viorels/zynthian-hw/MINI_V2/footprints/3dmodels/PJ-320A.step

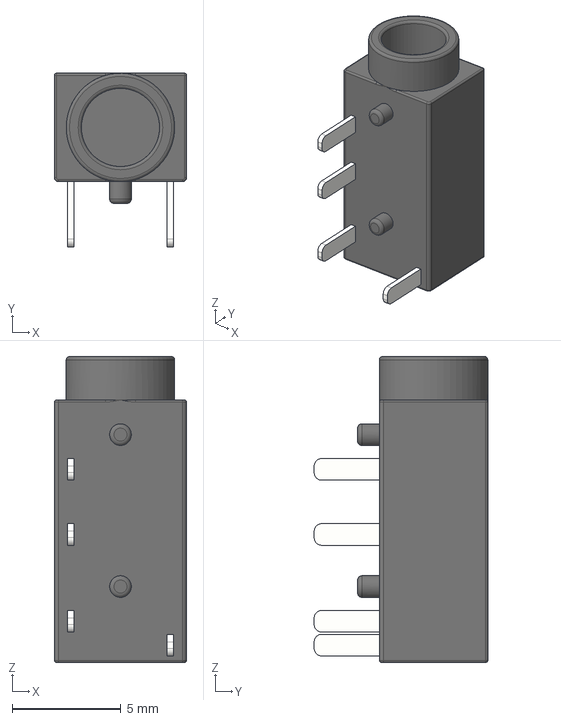
[picture p1: CAD file, 2025-03-14]
MINI_V2/footprints/3dmodels/PJ-320A.step
6.10 x 8.00 x 14.1 mm
