viorels/zynthian-hw/MINI_V2/zynthian-mini.kicad_pcb

## KiCad design MINI_V2/zynthian-mini.kicad_pcb (2025-03-16)

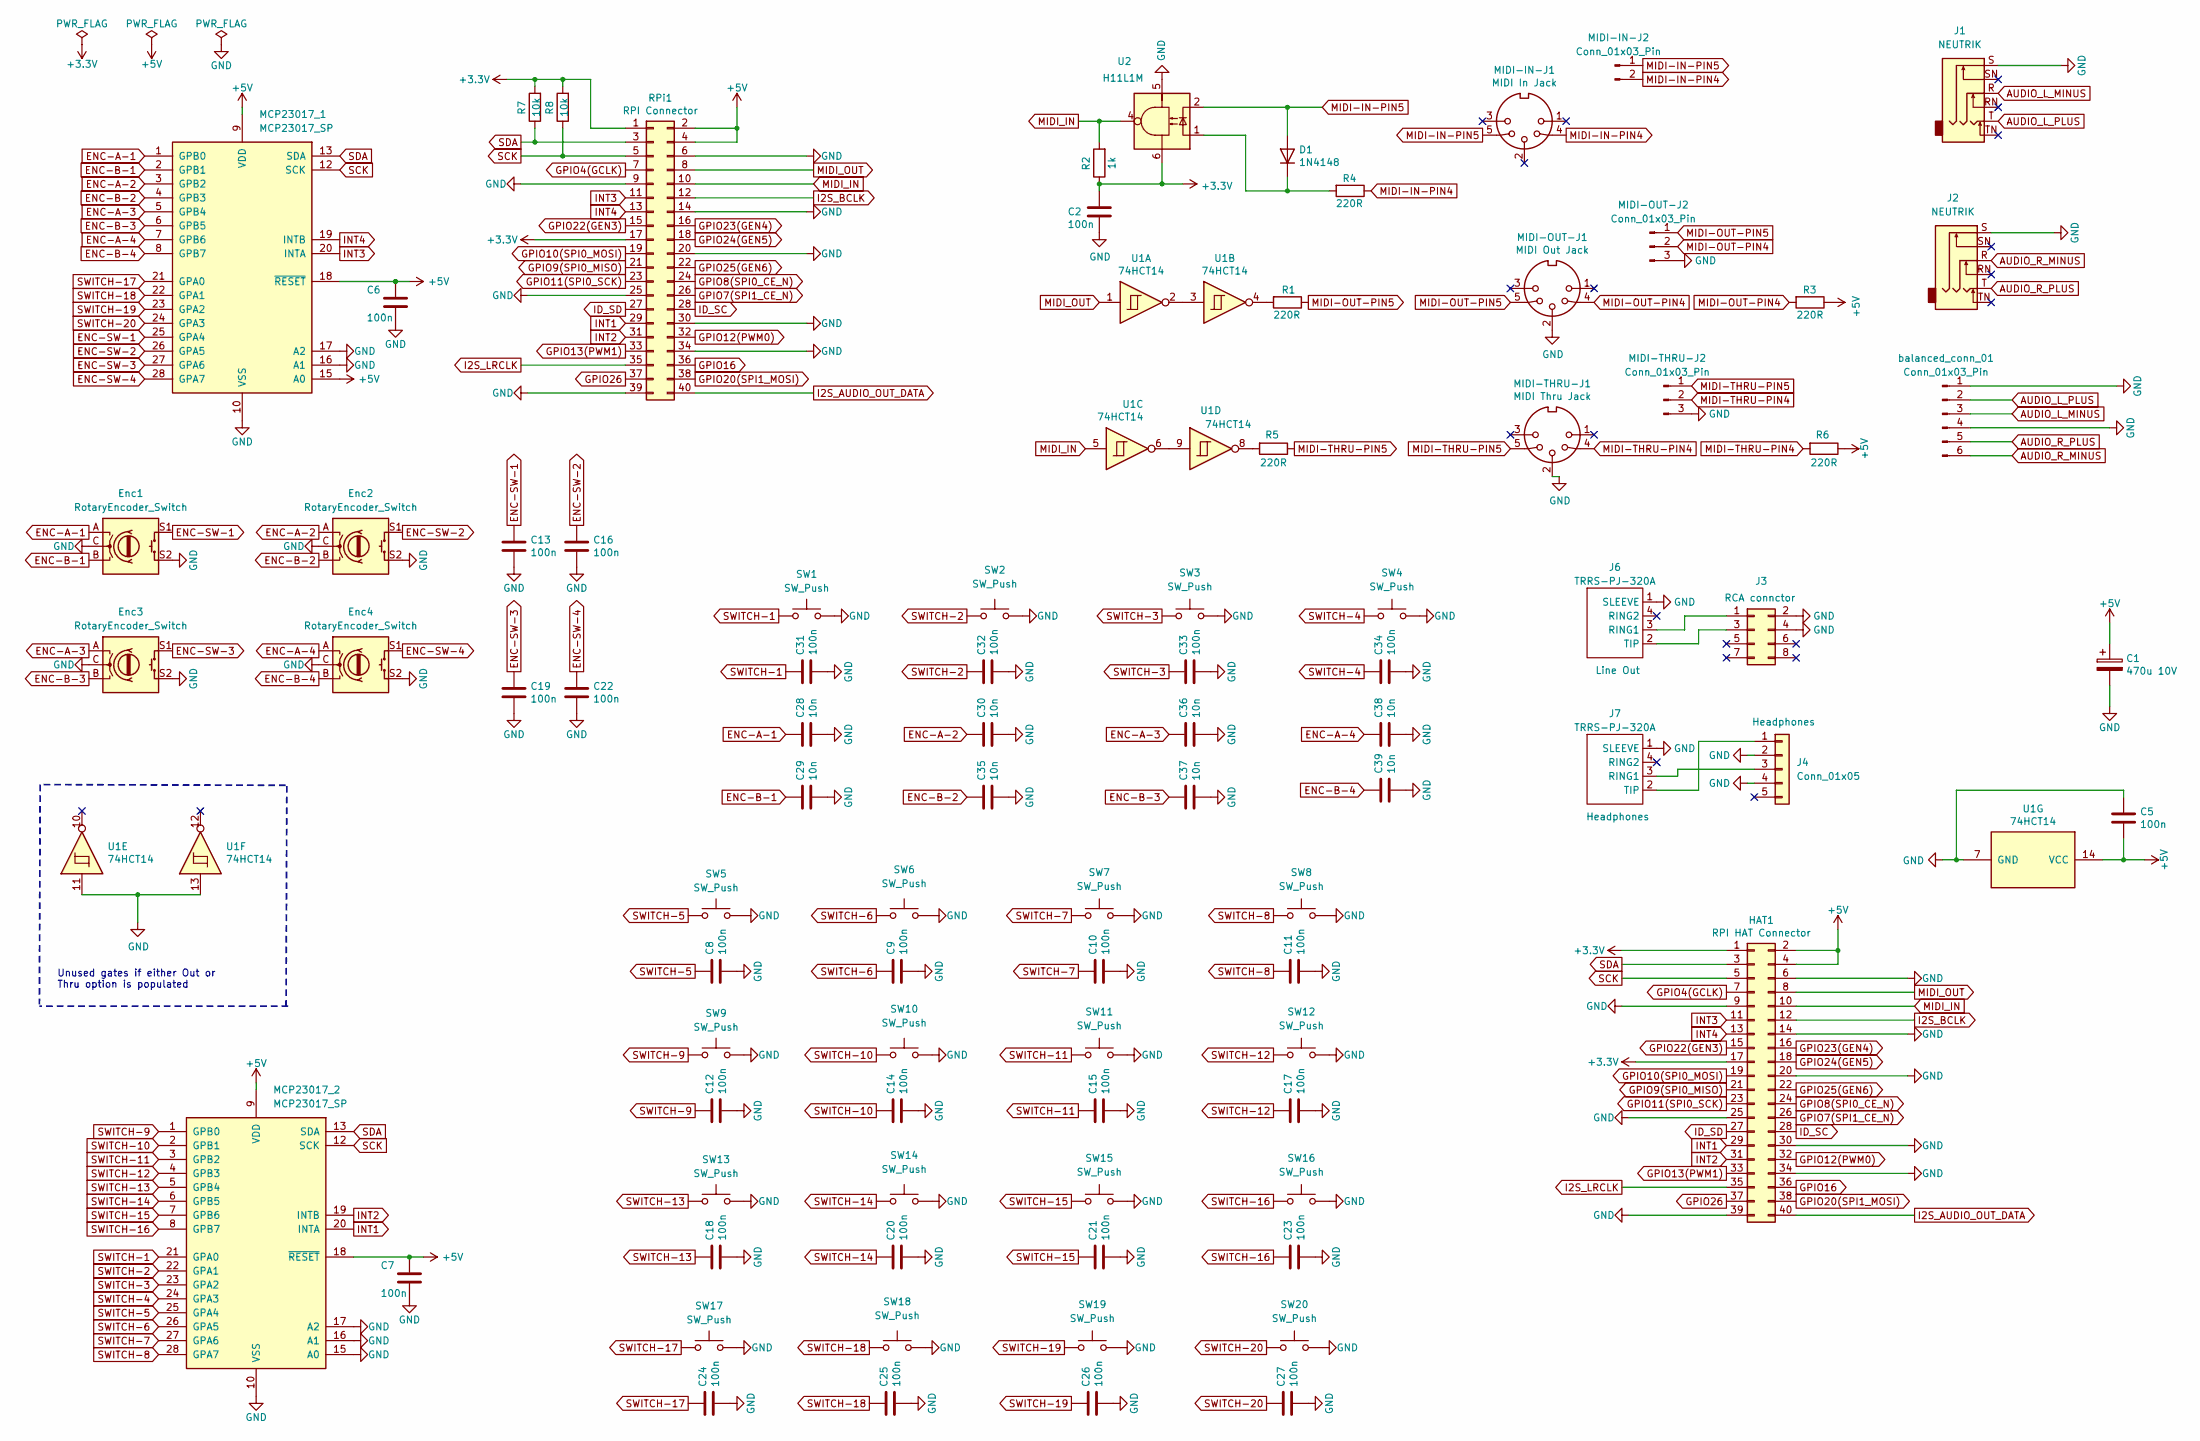
[picture p2: schematic zynthian-mini.kicad_sch, zynthian mini - v2 with 20 buttons]

Parts:
C1: 470u 10V; CP_Radial_D8.0mm_P3.50mm
C2, C5, C6, C7: 100n; C_Rect_L7.0mm_W2.0mm_P5.00mm
C8, C9, C10, C11, C12, C13, C14, C15, C16, C17, C18, C19, C20, C21, C22, C23, C24, C25, C26, C27, C31, C32, C33, C34: 100n; C_Rect_L4.0mm_W2.5mm_P2.50mm
C28, C29, C30, C35, C36, C37, C38, C39: 10n; C_Rect_L4.0mm_W2.5mm_P2.50mm
D1: 1N4148; D_DO-35_SOD27_P7.62mm_Horizontal
Enc1, Enc2, Enc3, Enc4: RotaryEncoder_Switch; RotaryEncoder_Alps_EC12E-Switch_Vertical_H20mm
HAT1: RPI HAT Connector; raspberry pi 4
J1, J2: NEUTRIK; Jack_6.35mm_Neutrik_NMJ6HFD2_Horizontal
J3: Conn_02x04_Odd_Even; PinHeader_2x04_P2.54mm_Vertical
J4: Conn_01x05; PinHeader_1x05_P2.54mm_Vertical
J6, J7: TRRS-PJ-320A; MPN TRRS-PJ-320A
MCP23017_1, MCP23017_2: MCP23017_SP; DIP-28_W7.62mm
MIDI-IN-J1: MIDI In Jack; MultiDIN5
MIDI-IN-J2: Conn_01x03_Pin; PinHeader_1x02_P2.54mm_Vertical
MIDI-OUT-J1: MIDI Out Jack; MultiDIN5
MIDI-OUT-J2: Conn_01x03_Pin; PinHeader_1x03_P2.54mm_Vertical
MIDI-THRU-J1: MIDI Thru Jack; MultiDIN5
MIDI-THRU-J2: Conn_01x03_Pin; PinHeader_1x03_P2.54mm_Vertical
R1, R3, R4, R5, R6: 220R; R_Axial_DIN0207_L6.3mm_D2.5mm_P7.62mm_Horizontal
R2: 1k; R_Axial_DIN0207_L6.3mm_D2.5mm_P7.62mm_Horizontal
R7, R8: 10k; R_Axial_DIN0207_L6.3mm_D2.5mm_P7.62mm_Horizontal
RPi1: RPI Connector; raspberry pi 4 HAT
SW1, SW2, SW3, SW4, SW5, SW6, SW7, SW8, SW9, SW10, SW11, SW12, SW13, SW14, SW15, SW16, SW17, SW18, SW19, SW20: SW_Push; push-button-13mm
U1: 74HCT14; DIP-14_W7.62mm
U2: H11L1M; DIP-6_W7.62mm
balanced_conn_01: Conn_01x03_Pin; PinHeader_1x06_P2.54mm_Vertical

Connections:
AUDIO_L_MINUS: J1.R, balanced_conn_01.3
AUDIO_L_PLUS: J1.T, balanced_conn_01.2
AUDIO_R_MINUS: J2.R, balanced_conn_01.6
AUDIO_R_PLUS: J2.T, balanced_conn_01.5
ENC-A-1: C28.1, Enc1.A, MCP23017_1.1 (GPB0)
ENC-A-2: C30.1, Enc2.A, MCP23017_1.3 (GPB2)
ENC-A-3: C36.1, Enc3.A, MCP23017_1.5 (GPB4)
ENC-A-4: C38.1, Enc4.A, MCP23017_1.7 (GPB6)
ENC-B-1: C29.1, Enc1.B, MCP23017_1.2 (GPB1)
ENC-B-2: C35.1, Enc2.B, MCP23017_1.4 (GPB3)
ENC-B-3: C37.1, Enc3.B, MCP23017_1.6 (GPB5)
ENC-B-4: C39.1, Enc4.B, MCP23017_1.8 (GPB7)
ENC-SW-1: C13.1, Enc1.S1, MCP23017_1.25 (GPA4)
ENC-SW-2: C16.1, Enc2.S1, MCP23017_1.26 (GPA5)
ENC-SW-3: C19.1, Enc3.S1, MCP23017_1.27 (GPA6)
ENC-SW-4: C22.1, Enc4.S1, MCP23017_1.28 (GPA7)
GPIO4(GCLK): HAT1.7, RPi1.7
GPIO7(SPI1_CE_N): HAT1.26, RPi1.26
GPIO8(SPI0_CE_N): HAT1.24, RPi1.24
GPIO9(SPI0_MISO): HAT1.21, RPi1.21
GPIO10(SPI0_MOSI): HAT1.19, RPi1.19
GPIO11(SPI0_SCK): HAT1.23, RPi1.23
GPIO12(PWM0): HAT1.32, RPi1.32
GPIO13(PWM1): HAT1.33, RPi1.33
GPIO16: HAT1.36, RPi1.36
GPIO20(SPI1_MOSI): HAT1.38, RPi1.38
GPIO22(GEN3): HAT1.15, RPi1.15
GPIO23(GEN4): HAT1.16, RPi1.16
GPIO24(GEN5): HAT1.18, RPi1.18
GPIO25(GEN6): HAT1.22, RPi1.22
GPIO26: HAT1.37, RPi1.37
I2S_AUDIO_OUT_DATA: HAT1.40, RPi1.40
I2S_BCLK: HAT1.12, RPi1.12
I2S_LRCLK: HAT1.35, RPi1.35
ID_SC: HAT1.28, RPi1.28
ID_SD: HAT1.27, RPi1.27
INT1: HAT1.29, MCP23017_2.20 (INTA), RPi1.29
INT2: HAT1.31, MCP23017_2.19 (INTB), RPi1.31
INT3: HAT1.11, MCP23017_1.20 (INTA), RPi1.11
INT4: HAT1.13, MCP23017_1.19 (INTB), RPi1.13
MIDI-IN-PIN4: MIDI-IN-J1.4, MIDI-IN-J2.2, R4.1
MIDI-IN-PIN5: D1.2 (A), MIDI-IN-J1.5, MIDI-IN-J2.1, U2.2
MIDI-OUT-PIN4: MIDI-OUT-J1.4, MIDI-OUT-J2.2, R3.2
MIDI-OUT-PIN5: MIDI-OUT-J1.5, MIDI-OUT-J2.1, R1.1
MIDI-THRU-PIN4: MIDI-THRU-J1.4, MIDI-THRU-J2.2, R6.2
MIDI-THRU-PIN5: MIDI-THRU-J1.5, MIDI-THRU-J2.1, R5.1
MIDI_IN: HAT1.10, R2.2, RPi1.10, U1.5, U2.4
MIDI_OUT: HAT1.8, RPi1.8, U1.1
unnamed: D1.1 (K), R4.2, U2.1
unnamed: J3.1, J6.3 (RING1)
unnamed: J3.3, J6.2 (TIP)
unnamed: J4.1, J7.2 (TIP)
unnamed: J4.3, J7.3 (RING1)
unnamed: R1.2, U1.4
unnamed: R5.2, U1.8
unnamed: U1.2, U1.3
unnamed: U1.6, U1.9
SCK: HAT1.5, MCP23017_1.12 (SCK), MCP23017_2.12 (SCK), R8.1, RPi1.5
SDA: HAT1.3, MCP23017_1.13 (SDA), MCP23017_2.13 (SDA), R7.1, RPi1.3
SWITCH-1: C31.1, MCP23017_2.21 (GPA0), SW1.1
SWITCH-2: C32.1, MCP23017_2.22 (GPA1), SW2.1
SWITCH-3: C33.1, MCP23017_2.23 (GPA2), SW3.1
SWITCH-4: C34.1, MCP23017_2.24 (GPA3), SW4.1
SWITCH-5: C8.1, MCP23017_2.25 (GPA4), SW5.1
SWITCH-6: C9.1, MCP23017_2.26 (GPA5), SW6.1
SWITCH-7: C10.1, MCP23017_2.27 (GPA6), SW7.1
SWITCH-8: C11.1, MCP23017_2.28 (GPA7), SW8.1
SWITCH-9: C12.1, MCP23017_2.1 (GPB0), SW9.1
SWITCH-10: C14.1, MCP23017_2.2 (GPB1), SW10.1
SWITCH-11: C15.1, MCP23017_2.3 (GPB2), SW11.1
SWITCH-12: C17.1, MCP23017_2.4 (GPB3), SW12.1
SWITCH-13: C18.1, MCP23017_2.5 (GPB4), SW13.1
SWITCH-14: C20.1, MCP23017_2.6 (GPB5), SW14.1
SWITCH-15: C21.1, MCP23017_2.7 (GPB6), SW15.1
SWITCH-16: C23.1, MCP23017_2.8 (GPB7), SW16.1
SWITCH-17: C24.1, MCP23017_1.21 (GPA0), SW17.1
SWITCH-18: C25.1, MCP23017_1.22 (GPA1), SW18.1
SWITCH-19: C26.1, MCP23017_1.23 (GPA2), SW19.1
SWITCH-20: C27.1, MCP23017_1.24 (GPA3), SW20.1

Notes on the sheet:
Unused gates if either Out or Thru option is populated

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
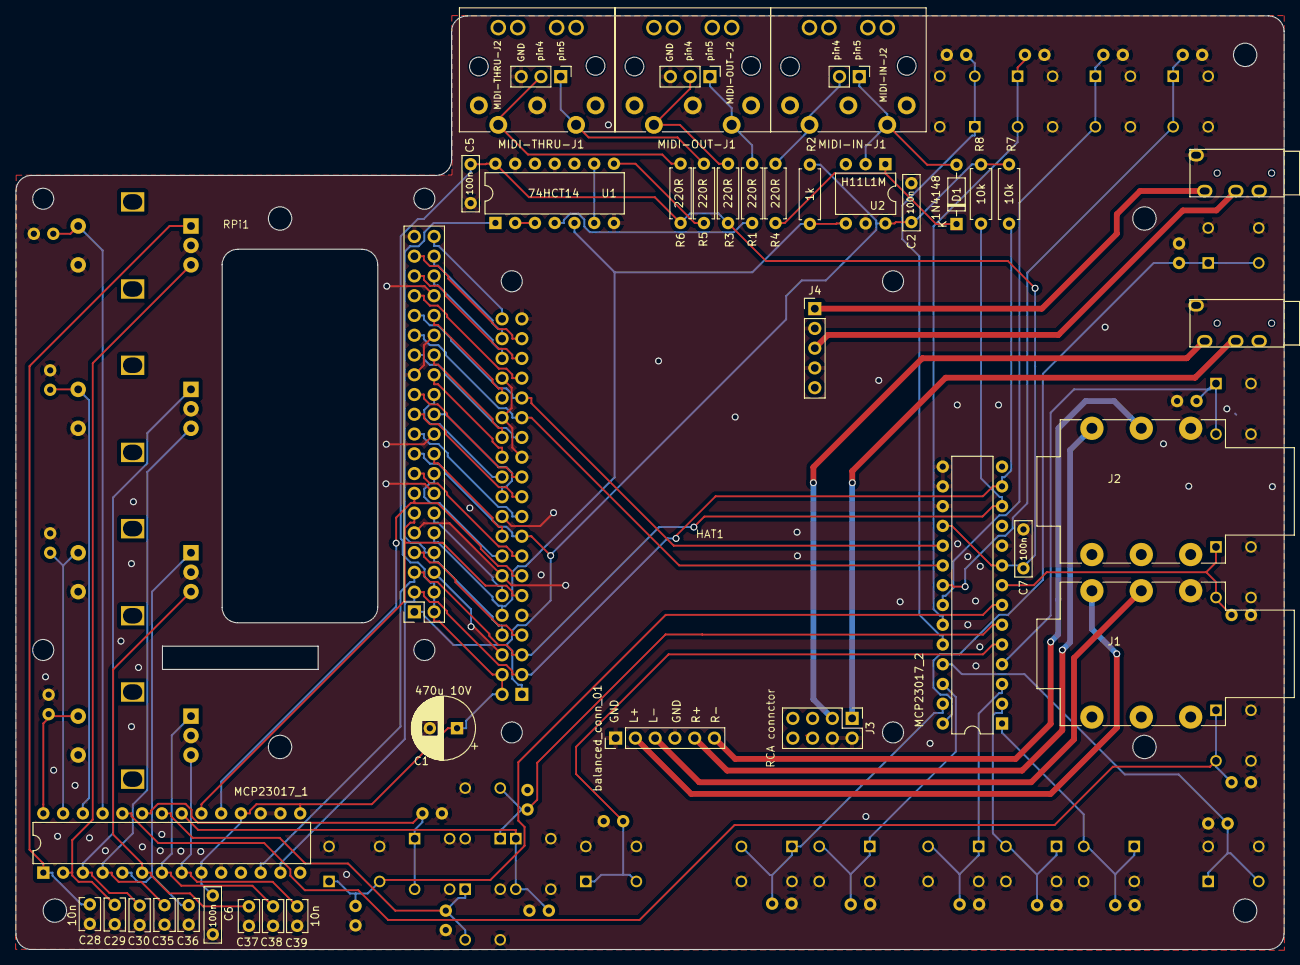
[picture p3: board zynthian-mini.kicad_pcb from above]

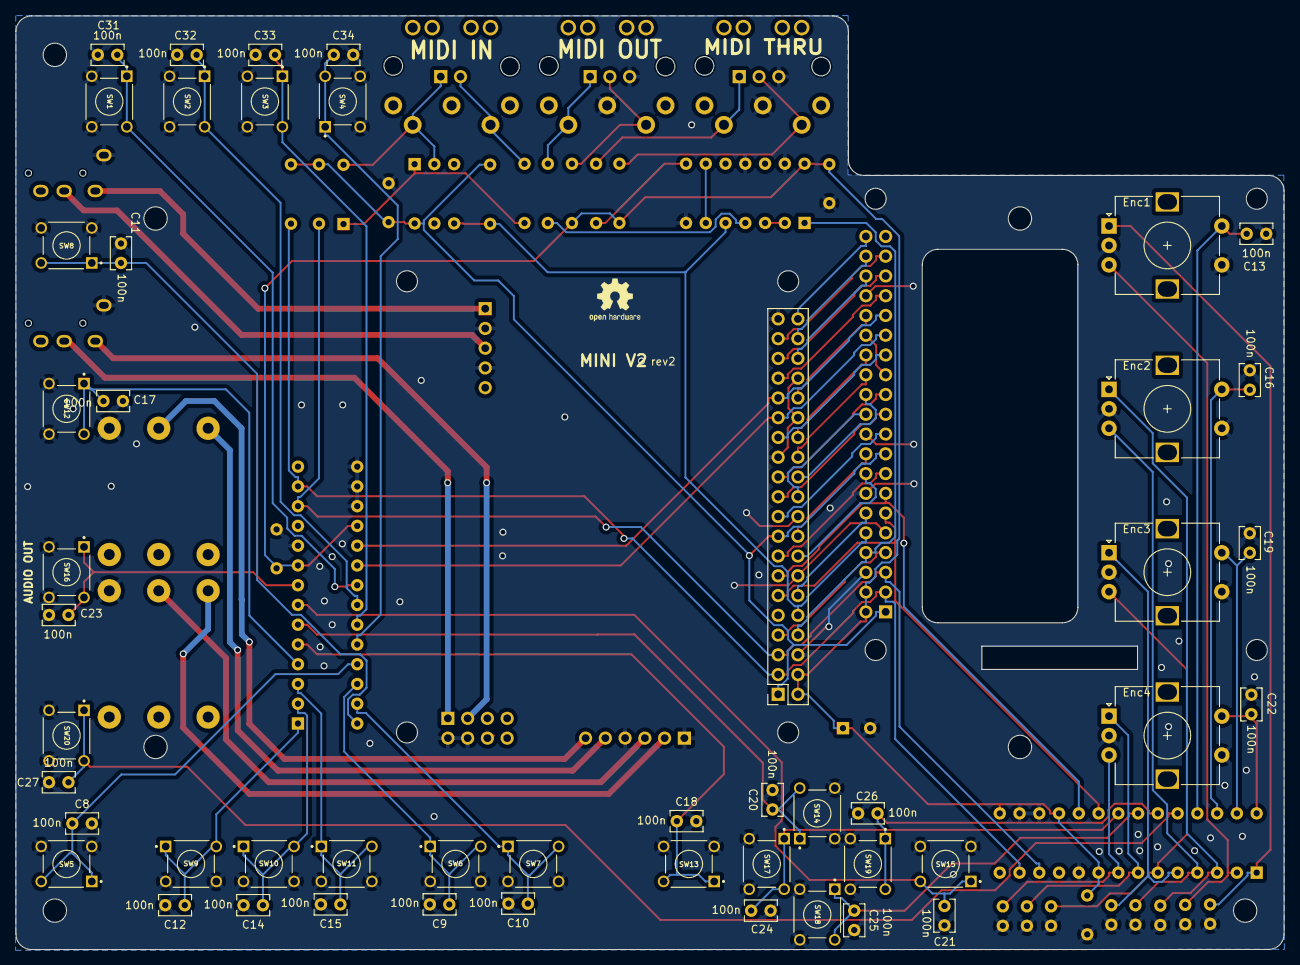
[picture p4: board zynthian-mini.kicad_pcb from below]

Board: 2 copper layers, 163.0 x 120.0 mm, 91 parts (49 on the bottom side), 82 nets.

Other parts of the board:
logo1: MINI V2; Zynthian Logo Mask
screen: aliexpress 5 inch screen
