viorels/zynthian-hw/(commit log)

2025-03-12 removed PCM sound card, resized pin connector from 3 to 6 pins
    [zynthian-mini.kicad_pcb, zynthian-mini.kicad_sch]
2025-03-13 2x6.3 connectors done, trying one mini jack
    [zynthian-mini.kicad_pcb, zynthian-mini.kicad_sch]
2025-03-14 add TRRS jack symbol and footprint, connect to line out
    [PJ-320A.step, zynthian-mini.kicad_pcb, zynthian-mini.kicad_sch]
2025-03-14 small cleanup for old traces, add 2nd mini jack
    [zynthian-mini.kicad_pcb, zynthian-mini.kicad_sch]
2025-03-15 finished schematic, added headphones jack
    [zynthian-mini.kicad_pcb, zynthian-mini.kicad_sch]
2025-03-15 finished all tracks, but pins not aligned
    [zynthian-mini.kicad_pcb]
2025-03-15 aligned connectors, rerouted; scree hole is covered by L-bal jack
    [zynthian-mini.kicad_pcb]
2025-03-16 moved 6.3 jacks to free screen hole
    [zynthian-mini.kicad_pcb]
2025-03-16 fixed "design rules checker"
    [zynthian-mini.kicad_pcb]
2025-03-16 thicker audio signals
    [zynthian-mini.kicad_pcb]
